Cheesylorry/Quantum-Demonstrator-Lite/pics/IMG_5399.png

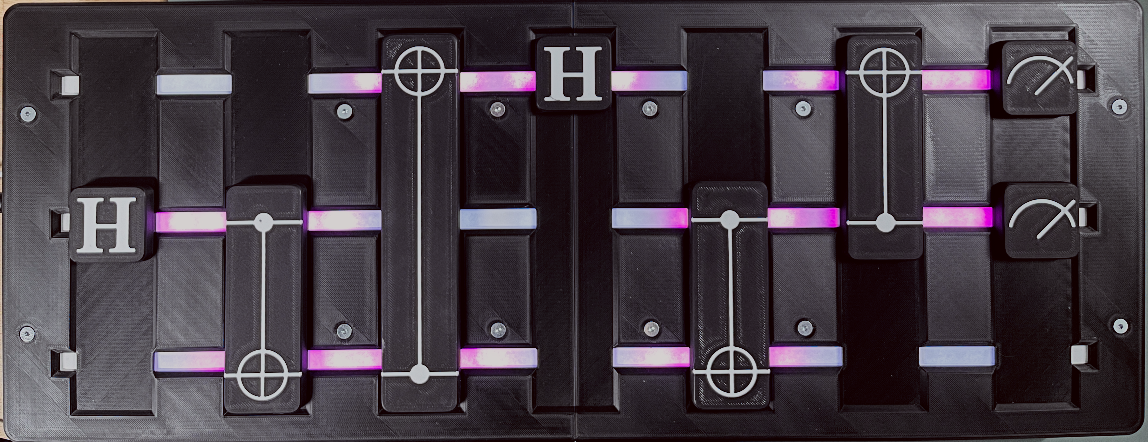
pics/IMG_5399.png
