Cheesylorry/Quantum-Demonstrator-Lite/pics/IMG_5399_v3.png

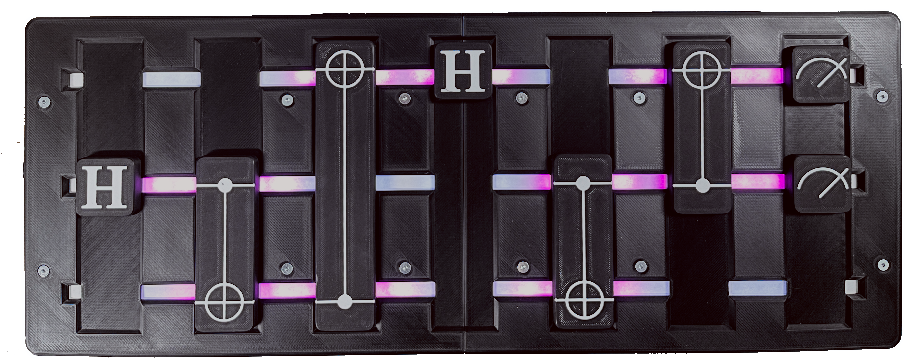
pics/IMG_5399_v3.png
