Cheesylorry/Quantum-Demonstrator-Lite/pics/IMG_5401.JPG

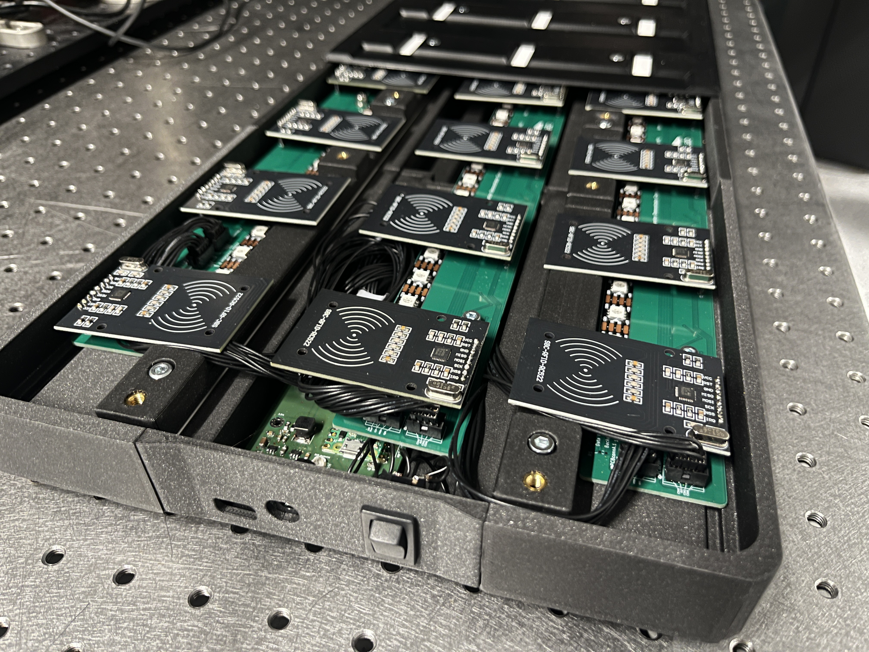
pics/IMG_5401.JPG
