Cheesylorry/Quantum-Demonstrator-Lite/pics/IMG_5409.JPG

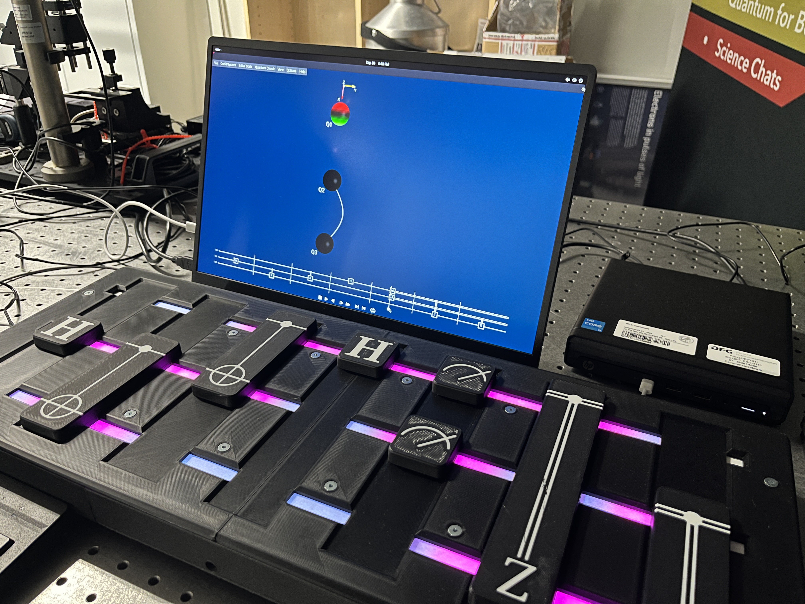
pics/IMG_5409.JPG
