Cheesylorry/Quantum-Demonstrator-Lite/pics/IMG_5411.JPG

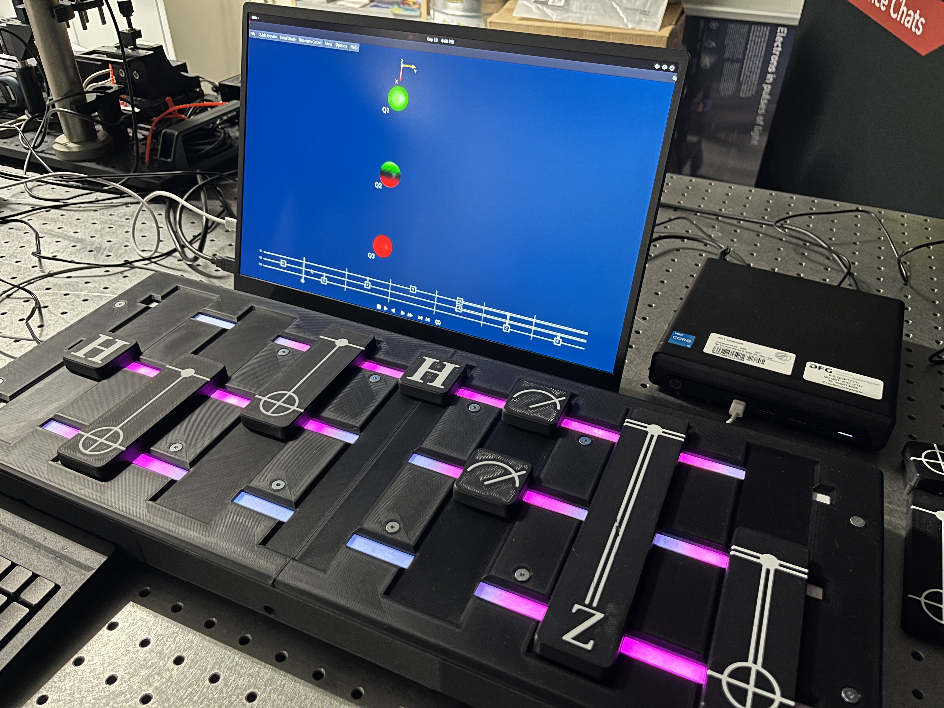
pics/IMG_5411.JPG
