Cheesylorry/Quantum-Demonstrator-Lite/pics/schematic_1.png

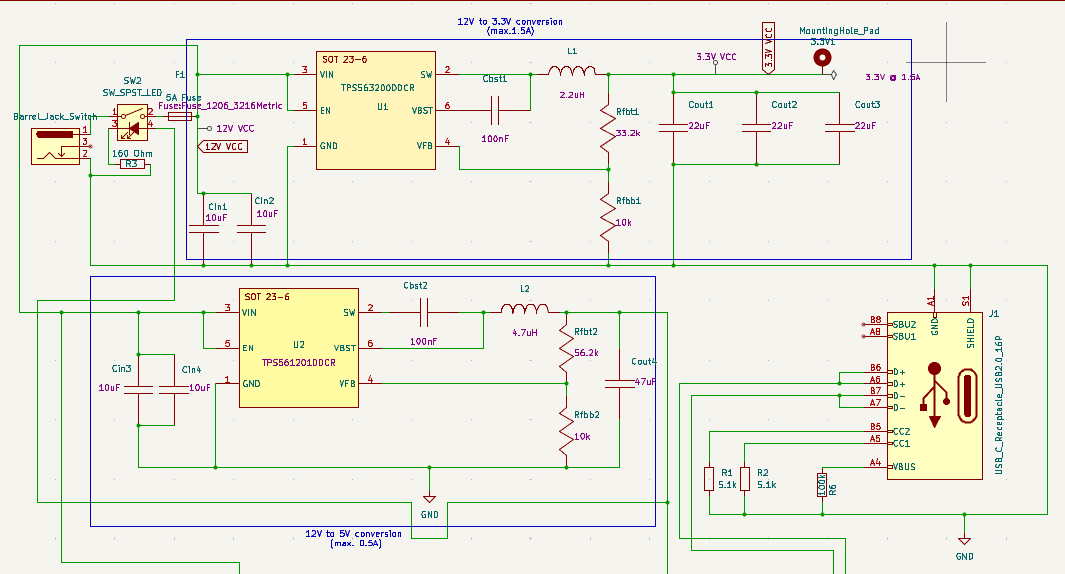
pics/schematic_1.png
