Cheesylorry/Quantum-Demonstrator-Lite/CAD files/Case Parts to 3D Print/All in one.step

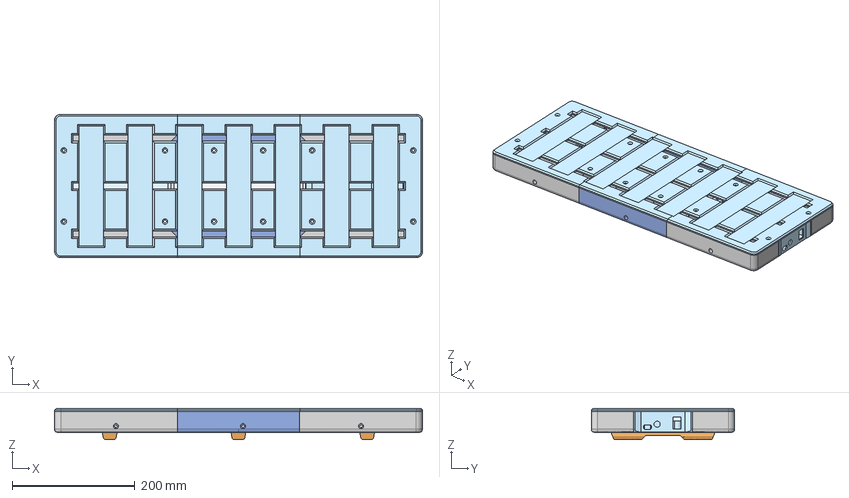
[picture p21: CAD file, 2026-10-16]
CAD files/Case Parts to 3D Print/All in one.step
600.3 x 234.0 x 51.0 mm
Rear Left shoulder x 2
Lid Part 3/1
Front Left shoulder
Foot x 3
Lid Part 1/3
Rear Middle
Middle Left shoulder
Central Front Piece
Rear right Shoulder
Lid Part 2
Middle Right shoulder
Middle Middle
