Cheesylorry/Quantum-Demonstrator-Lite/CAD files/Quantum Gates/Hadamard Gatter.step

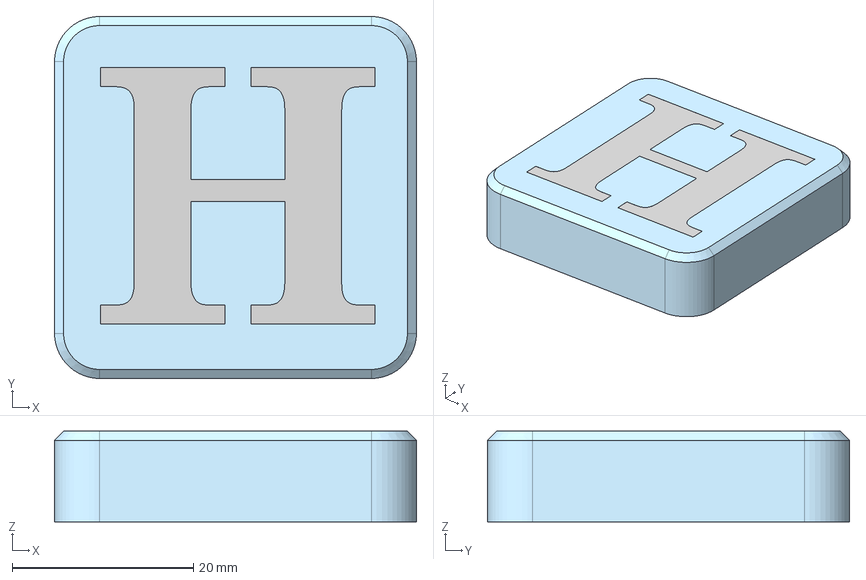
[picture p22: CAD file, 2026-10-16]
CAD files/Quantum Gates/Hadamard Gatter.step
40.0 x 40.0 x 10.0 mm
