Cheesylorry/Quantum-Demonstrator-Lite/CAD files/Quantum Gates/Cnot pos 2.step

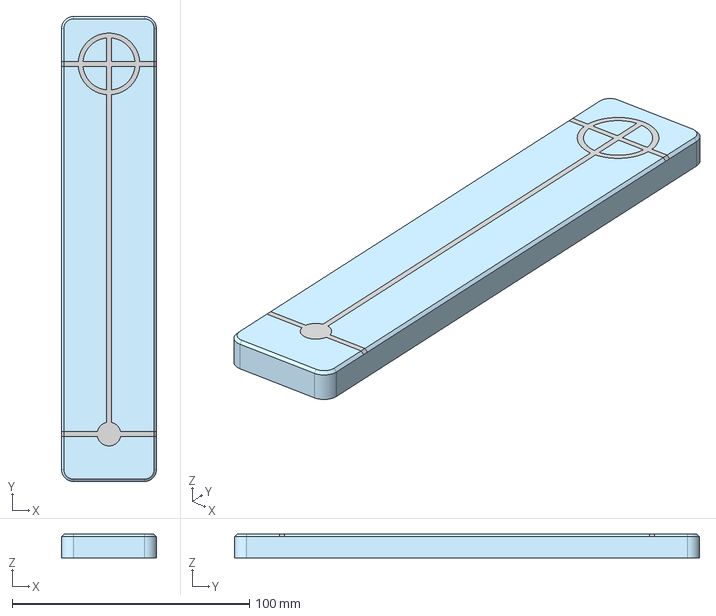
[picture p23: CAD file, 2026-10-16]
CAD files/Quantum Gates/Cnot pos 2.step
40.0 x 196.0 x 10.0 mm
