Cheesylorry/Quantum-Demonstrator-Lite/CAD files/Quantum Gates/CCnot pos 1.step

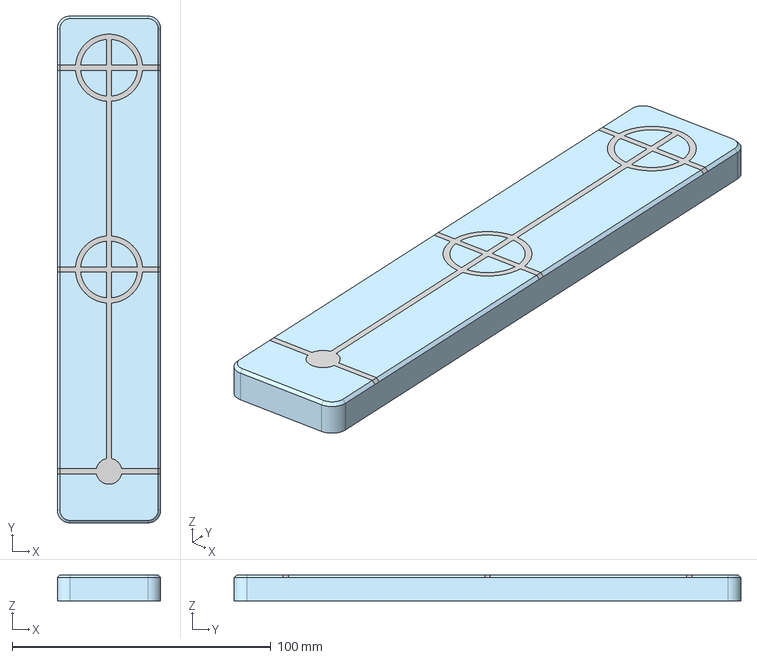
[picture p24: CAD file, 2026-10-16]
CAD files/Quantum Gates/CCnot pos 1.step
40.0 x 196.0 x 10.0 mm
