Cheesylorry/Quantum-Demonstrator-Lite/CAD files/Quantum Gates/Not Gatter.step

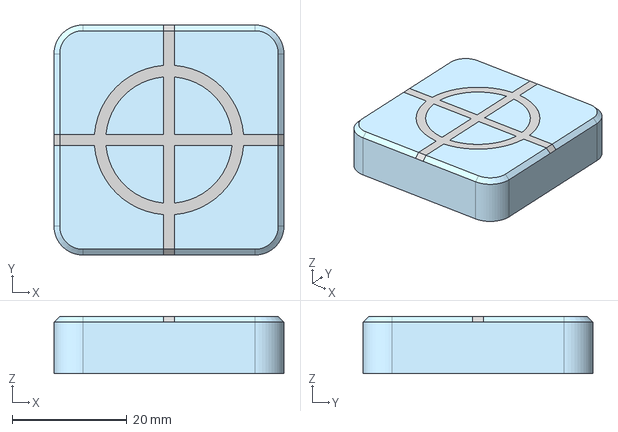
[picture p25: CAD file, 2026-10-16]
CAD files/Quantum Gates/Not Gatter.step
40.0 x 40.0 x 10.0 mm
