Cheesylorry/Quantum-Demonstrator-Lite/CAD files/Quantum Gates/Cnot pos 1.step

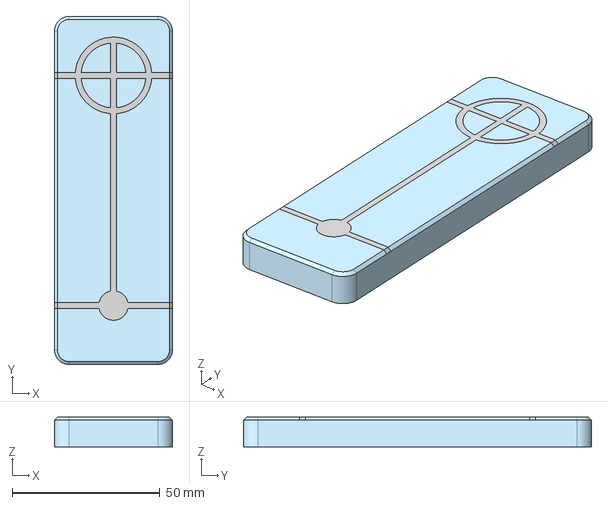
[picture p26: CAD file, 2026-10-16]
CAD files/Quantum Gates/Cnot pos 1.step
40.0 x 118.0 x 10.0 mm
