Cheesylorry/Quantum-Demonstrator-Lite/CAD files/Quantum Gates/Measurement.step

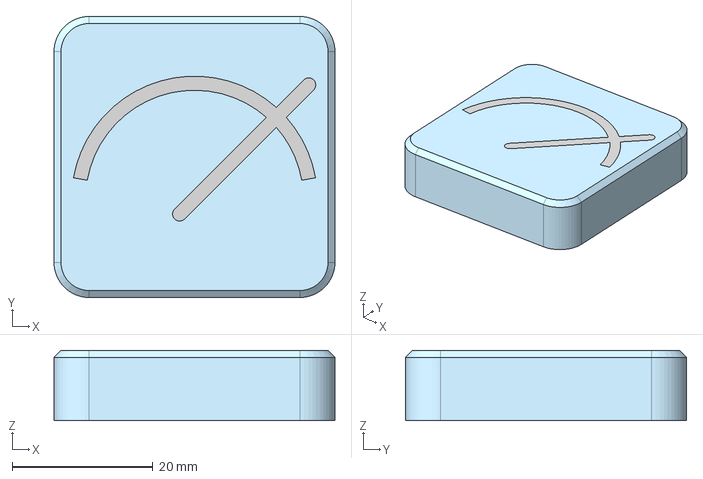
[picture p27: CAD file, 2026-10-16]
CAD files/Quantum Gates/Measurement.step
40.0 x 40.0 x 10.0 mm
