Cheesylorry/Quantum-Demonstrator-Lite/CAD files/Quantum Gates/Cnot classical pos1.step

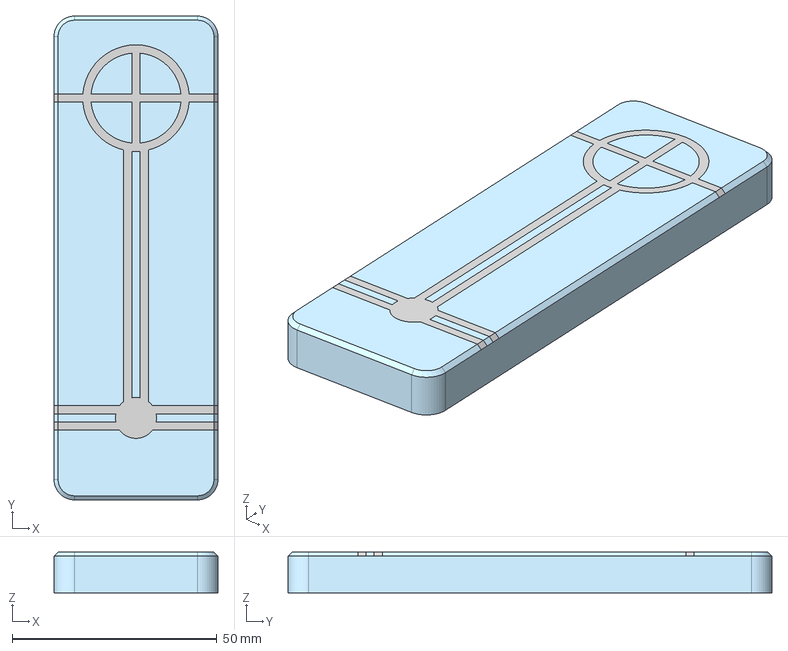
[picture p28: CAD file, 2026-10-16]
CAD files/Quantum Gates/Cnot classical pos1.step
40.0 x 118.0 x 10.0 mm
