Cheesylorry/Quantum-Demonstrator-Lite/CAD files/Complete Model (Including Screws)/QD_Lite_complete_model_V1_16_10_2026.step

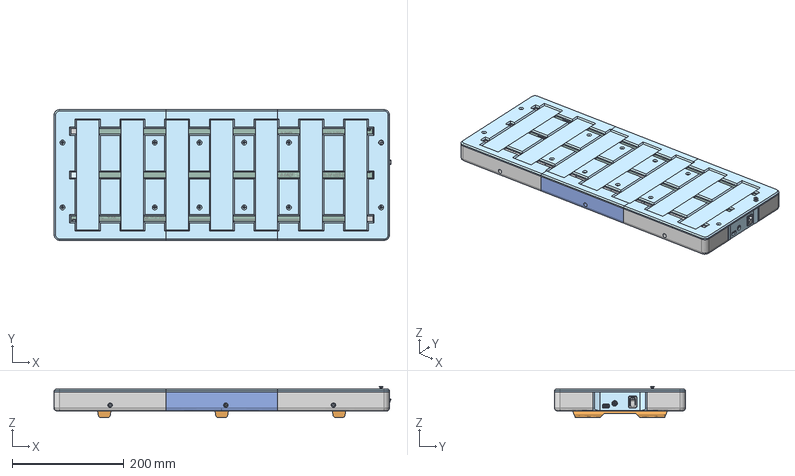
[picture p29: CAD file, 2026-10-16]
CAD files/Complete Model (Including Screws)/QD_Lite_complete_model_V1_16_10_2026.step
602.9 x 234.0 x 55.5 mm
Hex socket head cap screw M4x0.70 x 12 x 31
Hex socket head cap screw M4x0.70 x 40 x 6
Foot x 3
Middle Left shoulder
Rear Middle
Rear Left shoulder x 2
Rear right Shoulder
Lid Part 1/3
Middle Right shoulder
Front Left shoulder
Lid Part 3/1
Central Front Piece
2020_b594mm x 2
Middle Middle
P:\E-Switch Secure\3D_MODELS_STP_FORMAT\R1996AxxxxxxESxxx.stp
Hex socket head countersunk screw grade C M4x0.7 x 10
Lid Part 2
Conn_PCB_silkscreen x 666
R_0603_1608Metric x 6
PinSocket_1x08_P2.54mm_Vertical x 21
Conn_PCB_soldermask x 6
Conn_PCB_PCB x 3
USB_C_Receptacle_GCT_USB4105-xx-A_16P_TopMnt_Horizontal x 36
QD-lite_silkscreen x 292
R_0805_2012Metric x 8
C_0603_1608Metric x 3
SOT-23-6 x 2
QD-lite_soldermask x 2
QD-lite_PCB
C_0805_2012Metric x 6
Fuse_1206_3216Metric
RaspberryPi_Pico_Module_KiCad
L_1008_2520Metric
C_1206_3216Metric
L_APV_ANR6045
6941xx301002_PinBis
6941xx301002_Back
694106301002_PinContact
6941xx301002
6941xx301002_PinLame
6941xx301002_PinContact2
