Cheesylorry/Quantum-Demonstrator-Lite/(list of files, cad)

Other CAD files:
CAD files/Quantum Gates/CCnot pos 2.step
CAD files/Quantum Gates/Measurement classical pos 2.step
CAD files/Quantum Gates/Measurement classical pos 2 v2.step
CAD files/Quantum Gates/Controlled Z pos 2.step
