Cheesylorry/Quantum-Demonstrator-Lite/pics/schematic_main.pdf

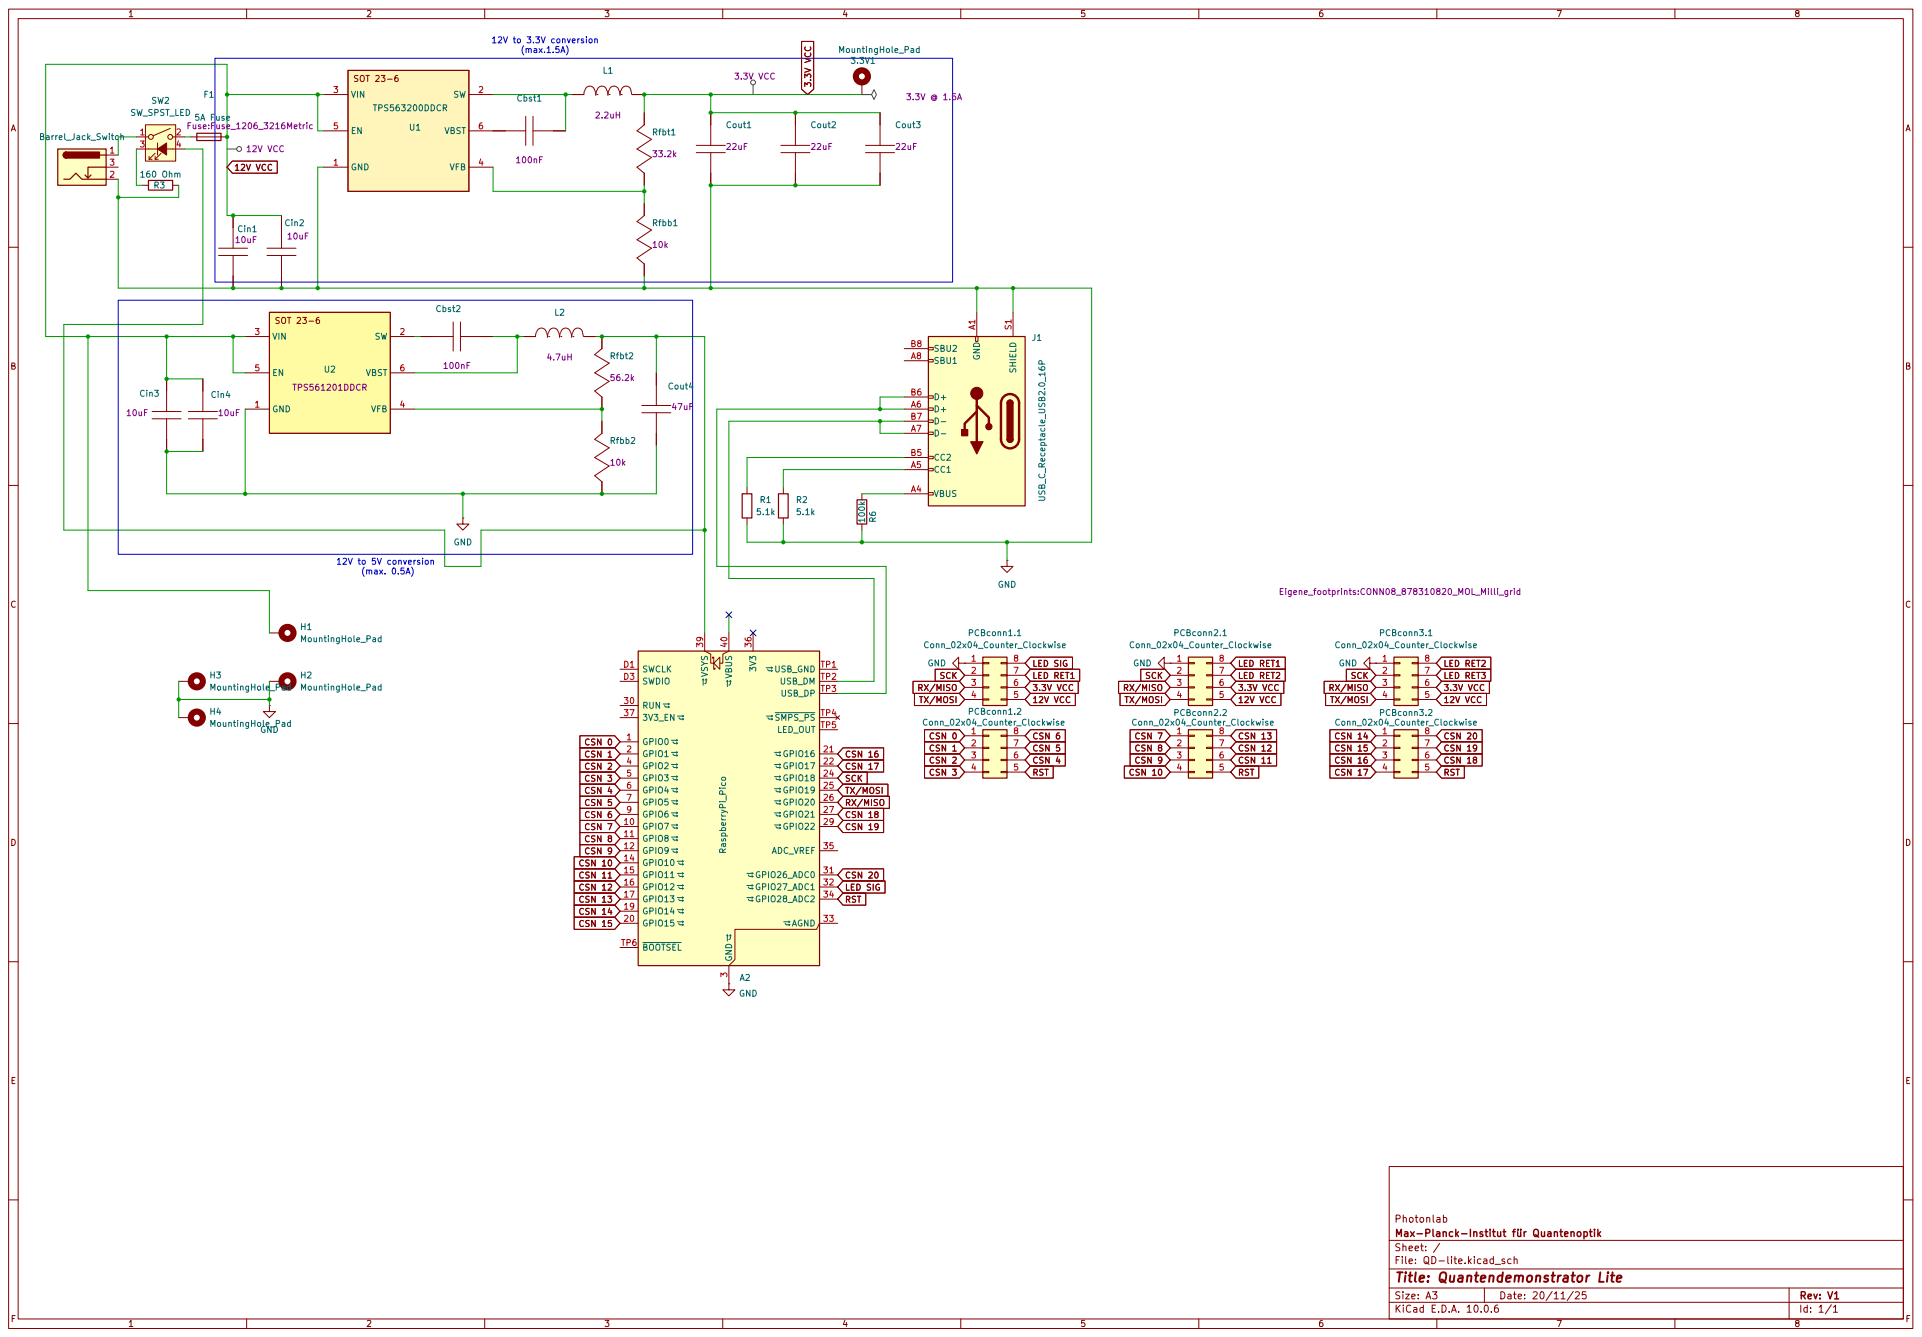
[picture p30: page 1]
