Cheesylorry/Quantum-Demonstrator-Lite/Electronics/Connection_PCB/Conn_PCB.kicad_pcb

## KiCad design Electronics/Connection_PCB/Conn_PCB.kicad_pcb (2026-10-16)

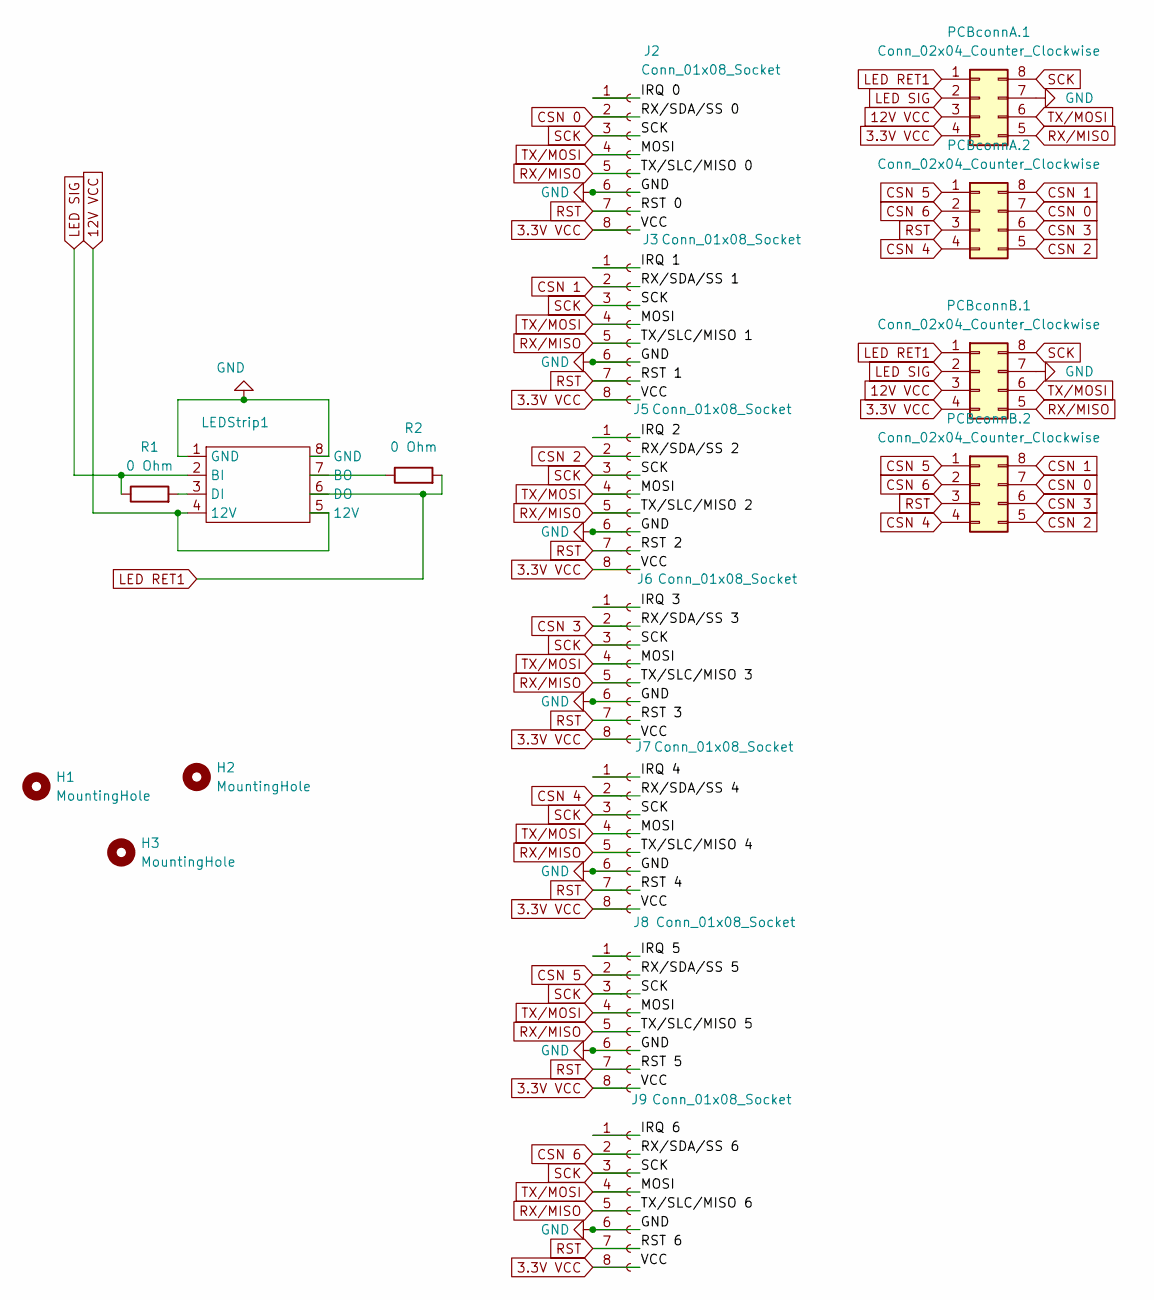
[picture p31: schematic Conn_PCB.kicad_sch]

Parts:
H1, H2: MountingHole; MountingHole_4.3x6.2mm_M4_Pad_Via
H3: MountingHole; MountingHole_4.3mm_M4_ISO14580_Pad
J2, J3, J5, J6, J7, J8, J9: Conn_01x08_Socket; PinSocket_1x08_P2.54mm_Vertical
LEDStrip1: LED strip Pad 2815
PCBconnA.1, PCBconnA.2: Conn_02x04_Counter_Clockwise; CONN08_878310820_MOL_Milli_grid
PCBconnB.1, PCBconnB.2: Conn_02x04_Counter_Clockwise; CONN08_878310820_MOL_Milli_grid
R1, R2: 0 Ohm; R_0603_1608Metric_Pad0.98x0.95mm_HandSolder

Connections:
3.3V VCC: J2.8, J3.8, J5.8, J6.8, J7.8, J8.8, J9.8, PCBconnA.1.4, PCBconnB.1.4
12V VCC: LEDStrip1.4 (12V), LEDStrip1.5 (12V), PCBconnA.1.3, PCBconnB.1.3
/IRQ 0: J2.1
/IRQ 1: J3.1
/IRQ 2: J5.1
/IRQ 3: J6.1
/IRQ 4: J7.1
/IRQ 5: J8.1
/IRQ 6: J9.1
CSN 0: J2.2, PCBconnA.2.7, PCBconnB.2.7
CSN 1: J3.2, PCBconnA.2.8, PCBconnB.2.8
CSN 2: J5.2, PCBconnA.2.5, PCBconnB.2.5
CSN 3: J6.2, PCBconnA.2.6, PCBconnB.2.6
CSN 4: J7.2, PCBconnA.2.4, PCBconnB.2.4
CSN 5: J8.2, PCBconnA.2.1, PCBconnB.2.1
CSN 6: J9.2, PCBconnA.2.2, PCBconnB.2.2
GND: J2.6, J3.6, J5.6, J6.6, J7.6, J8.6, J9.6, LEDStrip1.1 (GND), LEDStrip1.8 (GND), PCBconnA.1.7, PCBconnB.1.7
LED RET1: LEDStrip1.6 (DO), PCBconnA.1.1, PCBconnB.1.1, R2.2
LED SIG: LEDStrip1.2 (BI), PCBconnA.1.2, PCBconnB.1.2, R1.1
unnamed: LEDStrip1.7 (BO), R2.1
unnamed: LEDStrip1.3 (DI), R1.2
RST: J2.7, J3.7, J5.7, J6.7, J7.7, J8.7, J9.7, PCBconnA.2.3, PCBconnB.2.3
RX/MISO: J2.5, J3.5, J5.5, J6.5, J7.5, J8.5, J9.5, PCBconnA.1.5, PCBconnB.1.5
SCK: J2.3, J3.3, J5.3, J6.3, J7.3, J8.3, J9.3, PCBconnA.1.8, PCBconnB.1.8
TX/MOSI: J2.4, J3.4, J5.4, J6.4, J7.4, J8.4, J9.4, PCBconnA.1.6, PCBconnB.1.6

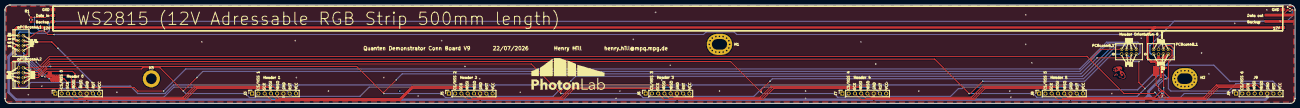
[picture p32: board Conn_PCB.kicad_pcb from above]

Board: 2 copper layers, 524.5 x 40.0 mm, 17 parts (0 on the bottom side), 18 nets.
