Cheesylorry/Quantum-Demonstrator-Lite/Electronics/Main_PCB/QD-lite.kicad_pcb

## KiCad design Electronics/Main_PCB/QD-lite.kicad_pcb (2026-10-16)

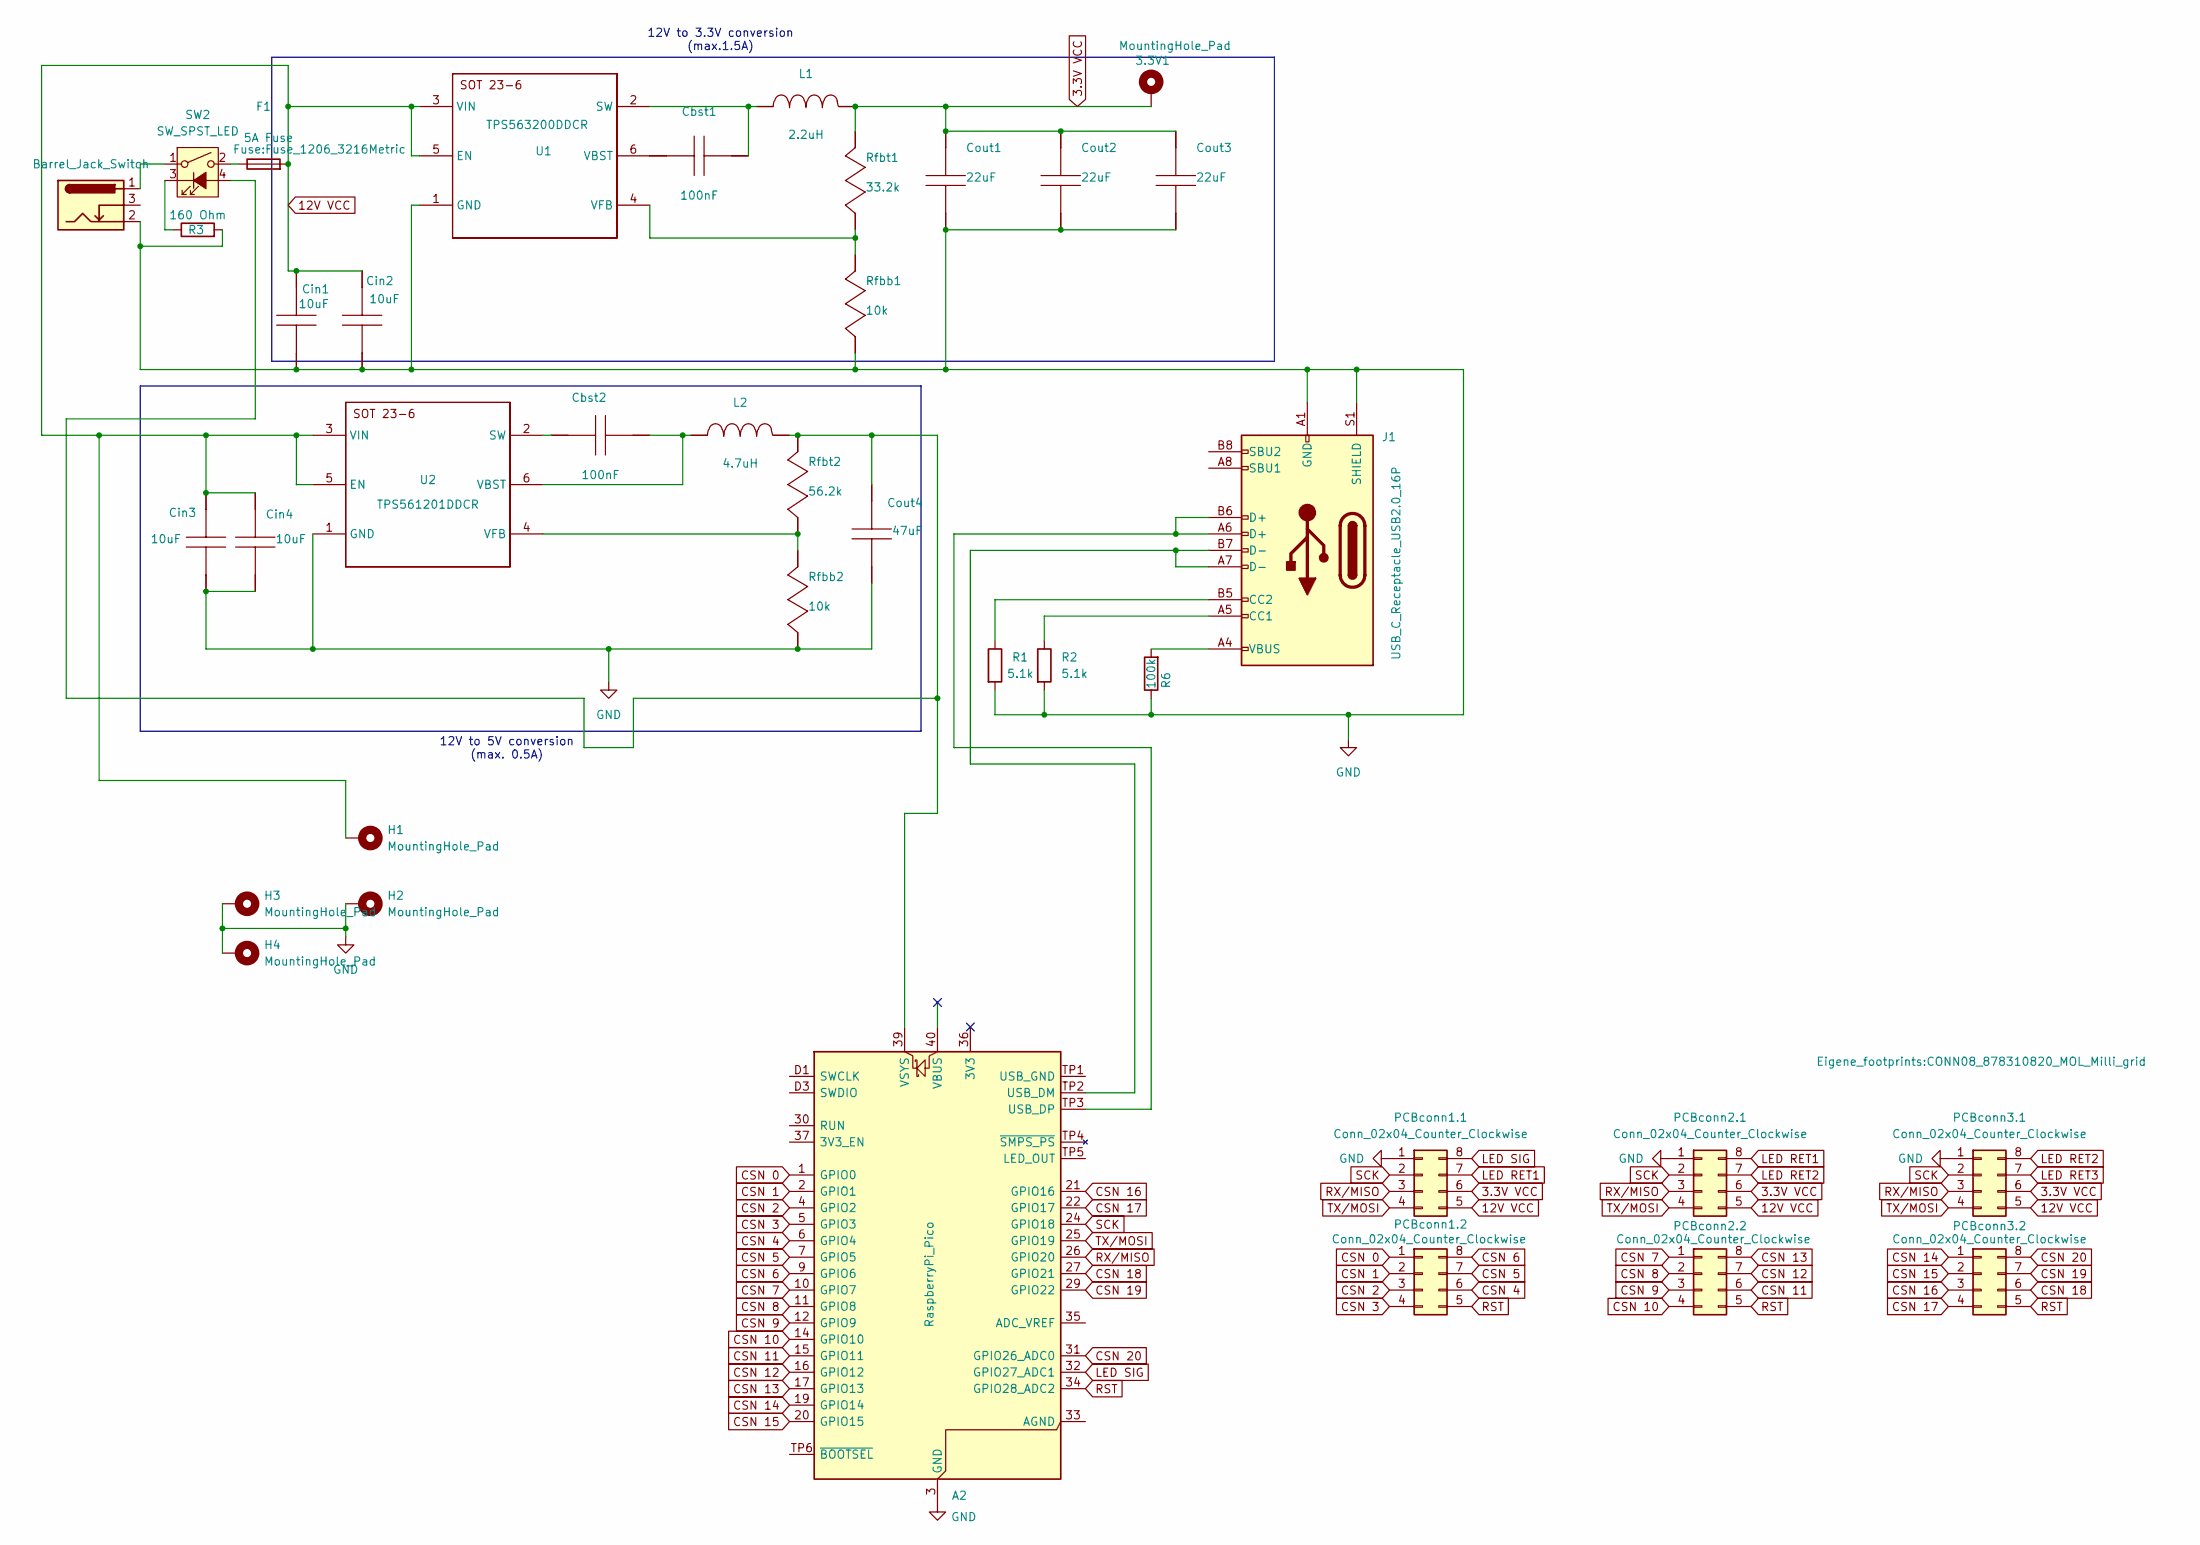
[picture p33: schematic QD-lite.kicad_sch, Quantendemonstrator Lite]

Parts:
3.3V1: MountingHole_Pad; MountingHole_2.5mm_Pad_Via
A2: RaspberryPi_Pico; RaspberryPi_Pico_SMD
Cbst1, Cbst2: 08053C104KAT2A; C_0805_2012Metric_Pad1.18x1.45mm_HandSolder; MANUFACTURER PART NUMBER 08053C104KAT2A
Cin1, Cin2: MSAST219LB5106KTNA01; C_0805_2012Metric_Pad1.18x1.45mm_HandSolder; MANUFACTURER PART NUMBER MSAST219LB5106KTNA01
Cin3, Cin4: MSAST219LB5106KTNA01; C_0805_2012Metric_Pad1.18x1.45mm_HandSolder; MANUFACTURER PART NUMBER MSAST21GBB5106MTNA01
Cout1, Cout2, Cout3: GRM188R60J226MEA0D; C_0603_1608Metric_Pad1.08x0.95mm_HandSolder; MANUFACTURER PART NUMBER GRM188R60J226MEA0D
Cout4: C3216X5R1C476M160AB; C_1206_3216Metric_Pad1.33x1.80mm_HandSolder; MANUFACTURER PART NUMBER C3216X5R1C476M160AB
F1: 5A Fuse; Fuse_1206_3216Metric
H1, H2: MountingHole_Pad; MountingHole_2.2mm_M2_DIN965_Pad_TopBottom
H3, H4: MountingHole_Pad; MountingHole_2.7mm_M2.5_Pad_Via
J1: USB_C_Receptacle_USB2.0_16P; USB_C_Receptacle_GCT_USB4105-xx-A_16P_TopMnt_Horizontal
J4: Barrel_Jack_Switch; BarrelJack_Wuerth_6941xx301002_CAD
L1: VLS6045EX-2R2N; L_APV_ANR6045; MANUFACTURER PART NUMBER VLP8040T-2R2N
L2: LQM2HPN4R7MG0L; L_1008_2520Metric_Pad1.43x2.20mm_HandSolder; MANUFACTURER PART NUMBER LQM2HPN4R7MG0L
PCBconn1.1, PCBconn1.2, PCBconn2.1, PCBconn2.2, PCBconn3.1, PCBconn3.2: Conn_02x04_Counter_Clockwise; CONN08_878310820_MOL_Milli_grid
R1: 5.1k; R_0805_2012Metric_Pad1.20x1.40mm_HandSolder
R2: 5.1k; R_0805_2012Metric
R3: 160 Ohm; R_0805_2012Metric_Pad1.20x1.40mm_HandSolder
R6: 100k; R_0805_2012Metric
Rfbb1, Rfbb2: RC0805FR-0710KL; R_0805_2012Metric_Pad1.20x1.40mm_HandSolder; MANUFACTURER PART NUMBER RC0805FR-0710KL
Rfbt1: CRCW080533K2FKEA; R_0805_2012Metric_Pad1.20x1.40mm_HandSolder; MANUFACTURER PART NUMBER CRCW080533K2FKEA
Rfbt2: RC0805FR-0756K2L; R_0805_2012Metric_Pad1.20x1.40mm_HandSolder; MANUFACTURER PART NUMBER RC0805FR-0756K2L
SW2: SW_SPST_LED; R1966ABLKBLKESRED footprint
U1: TPS563200DDCR; SOT-23-6; MANUFACTURER PART NUMBER TPS563209DDCR
U2: TPS561201DDCR; SOT-23-6; MANUFACTURER PART NUMBER TPS561201DDCR

Connections:
3.3V VCC: 3.3V1.1 (1_1), Cout1.1, Cout2.1, Cout3.1, L1.2, PCBconn1.1.6, PCBconn2.1.6, PCBconn3.1.6, Rfbt1.1
12V VCC: Cin1.1, Cin2.1, Cin3.1, Cin4.1, F1.2, H1.1 (1_1), PCBconn1.1.5, PCBconn2.1.5, PCBconn3.1.5, U1.3 (VIN), U1.5 (EN), U2.3 (VIN), U2.5 (EN)
CSN 0: A2.1 (GPIO0), PCBconn1.2.1
CSN 1: A2.2 (GPIO1), PCBconn1.2.2
CSN 2: A2.4 (GPIO2), PCBconn1.2.3
CSN 3: A2.5 (GPIO3), PCBconn1.2.4
CSN 4: A2.6 (GPIO4), PCBconn1.2.6
CSN 5: A2.7 (GPIO5), PCBconn1.2.7
CSN 6: A2.9 (GPIO6), PCBconn1.2.8
CSN 7: A2.10 (GPIO7), PCBconn2.2.1
CSN 8: A2.11 (GPIO8), PCBconn2.2.2
CSN 9: A2.12 (GPIO9), PCBconn2.2.3
CSN 10: A2.14 (GPIO10), PCBconn2.2.4
CSN 11: A2.15 (GPIO11), PCBconn2.2.6
CSN 12: A2.16 (GPIO12), PCBconn2.2.7
CSN 13: A2.17 (GPIO13), PCBconn2.2.8
CSN 14: A2.19 (GPIO14), PCBconn3.2.1
CSN 15: A2.20 (GPIO15), PCBconn3.2.2
CSN 16: A2.21 (GPIO16), PCBconn3.2.3
CSN 17: A2.22 (GPIO17), PCBconn3.2.4
CSN 18: A2.27 (GPIO21), PCBconn3.2.6
CSN 19: A2.29 (GPIO22), PCBconn3.2.7
CSN 20: A2.31 (GPIO26_ADC0), PCBconn3.2.8
GND: A2.3 (GND), A2.8 (GND), A2.13 (GND), A2.18 (GND), A2.23 (GND), A2.28 (GND), A2.38 (GND), A2.D2 (GND), Cin1.2, Cin2.2, Cin3.2, Cin4.2, Cout1.2, Cout2.2, Cout3.2, Cout4.2, H2.1 (1_1), H3.1 (1_1), H4.1 (1_1), J1.A1 (GND), J1.A12 (GND), J1.B1 (GND), J1.B12 (GND), J1.S1 (SHIELD), J4.2, PCBconn1.1.1, PCBconn2.1.1, PCBconn3.1.1, R1.2, R2.2, R3.2, R6.1, Rfbb1.2, Rfbb2.2, U1.1 (GND), U2.1 (GND)
LED RET1: PCBconn1.1.7, PCBconn2.1.8
LED RET2: PCBconn2.1.7, PCBconn3.1.8
LED RET3: PCBconn3.1.7
LED SIG: A2.32 (GPIO27_ADC1), PCBconn1.1.8
unnamed: A2.TP2 (USB_DM), J1.A7 (D-), J1.B7 (D-)
unnamed: A2.TP3 (USB_DP), J1.A6 (D+), J1.B6 (D+)
unnamed: A2.39 (VSYS), Cout4.1, L2.2, Rfbt2.1, SW2.4 (A)
unnamed: F1.1, SW2.2
unnamed: J1.A5 (CC1), R2.1
unnamed: J1.B5 (CC2), R1.1
unnamed: J1.A4 (VBUS), J1.A9 (VBUS), J1.B4 (VBUS), J1.B9 (VBUS), R6.2
unnamed: J4.1, SW2.1
unnamed: R3.1, SW2.3 (K)
unnamed: Cbst1.1, L1.1, U1.2 (SW)
unnamed: Cbst1.2, U1.6 (VBST)
unnamed: Rfbb1.1, Rfbt1.2, U1.4 (VFB)
unnamed: Cbst2.2, U2.2 (SW)
unnamed: Cbst2.1, L2.1, U2.6 (VBST)
unnamed: Rfbb2.1, Rfbt2.2, U2.4 (VFB)
RST: A2.34 (GPIO28_ADC2), PCBconn1.2.5, PCBconn2.2.5, PCBconn3.2.5
RX/MISO: A2.26 (GPIO20), PCBconn1.1.3, PCBconn2.1.3, PCBconn3.1.3
SCK: A2.24 (GPIO18), PCBconn1.1.2, PCBconn2.1.2, PCBconn3.1.2
TX/MOSI: A2.25 (GPIO19), PCBconn1.1.4, PCBconn2.1.4, PCBconn3.1.4

Notes on the sheet:
12V to 3.3V conversion (max.1.5A)
12V to 5V conversion (max. 0.5A)

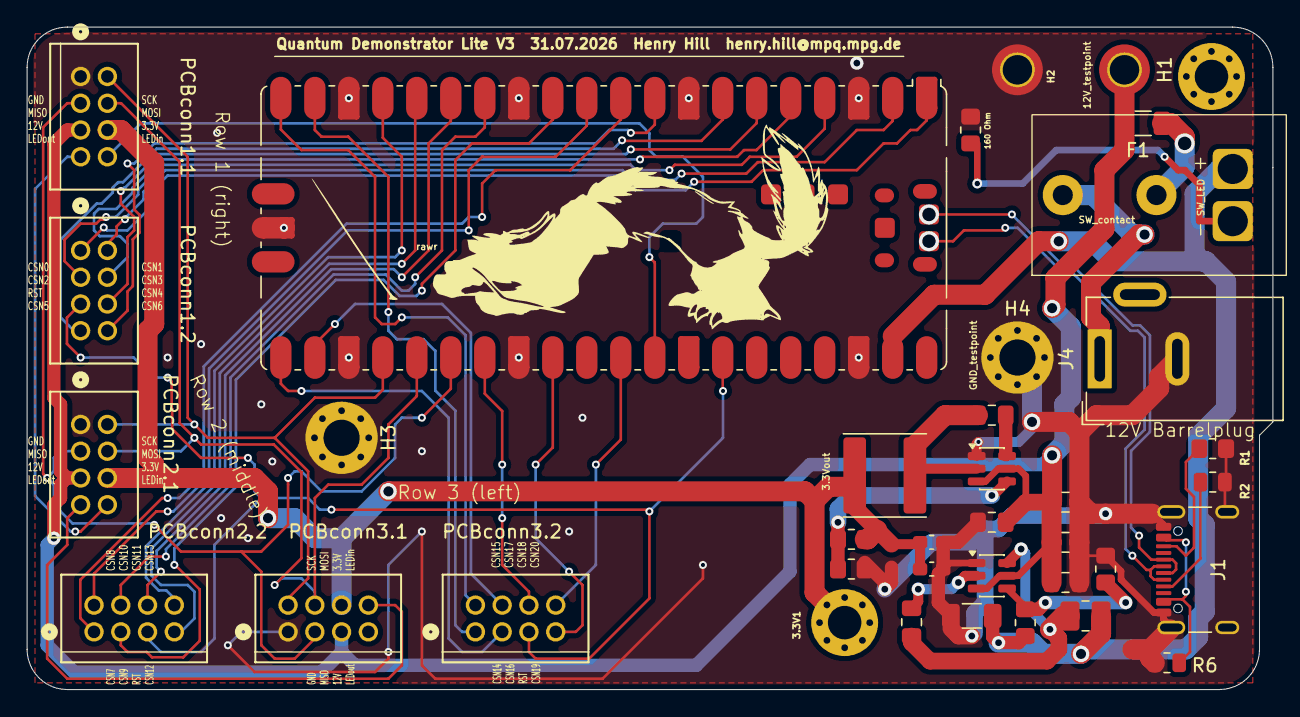
[picture p34: board QD-lite.kicad_pcb from above]

Board: 2 copper layers, 93.1 x 49.5 mm, 39 parts (1 on the bottom side), 46 nets.

Other parts of the board:
M2.5: MountingHole_2.5mm_Pad_Via
