Cheesylorry/Quantum-Demonstrator-Lite/(commit log)

2026-10-16 Update 1
    [Conn_PCB.kicad_pcb, Conn_PCB.kicad_sch, QD-lite.kicad_pcb, QD-lite.kicad_sch, gates.csv]
2026-10-16 Expanded README.md, added PC side implimentation.
    [QD_Lite_complete_model_V1_16_10_2026.step, gates.csv]
2026-10-16 Push to prod on a Friday
    [All in one.step, Cnot classical pos1.step, Hadamard Gatter.step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]
2026-10-21 Fixed Typos, Fixed witing errors, redid naming, added comments
    [composer.py, enroll.py, writer.py]
2026-10-22 Updated Readme, Improved Comments in code, fixed writing error
    [database.py, enroll.py, selftest.py, serial_link.py]
