Cheesylorry/Quantum-Demonstrator-Lite/pics/IMG_5399.JPG

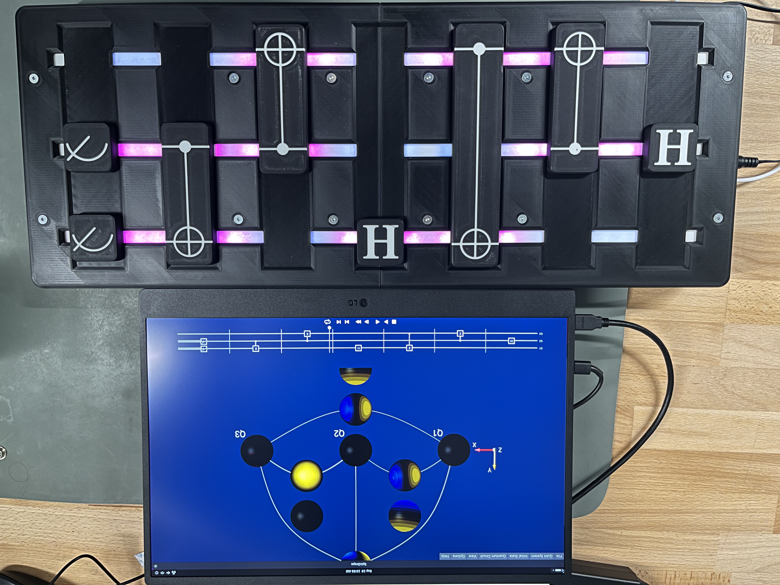
pics/IMG_5399.JPG
