Cheesylorry/Quantum-Demonstrator-Lite/pics/IMG_5399_v2.png

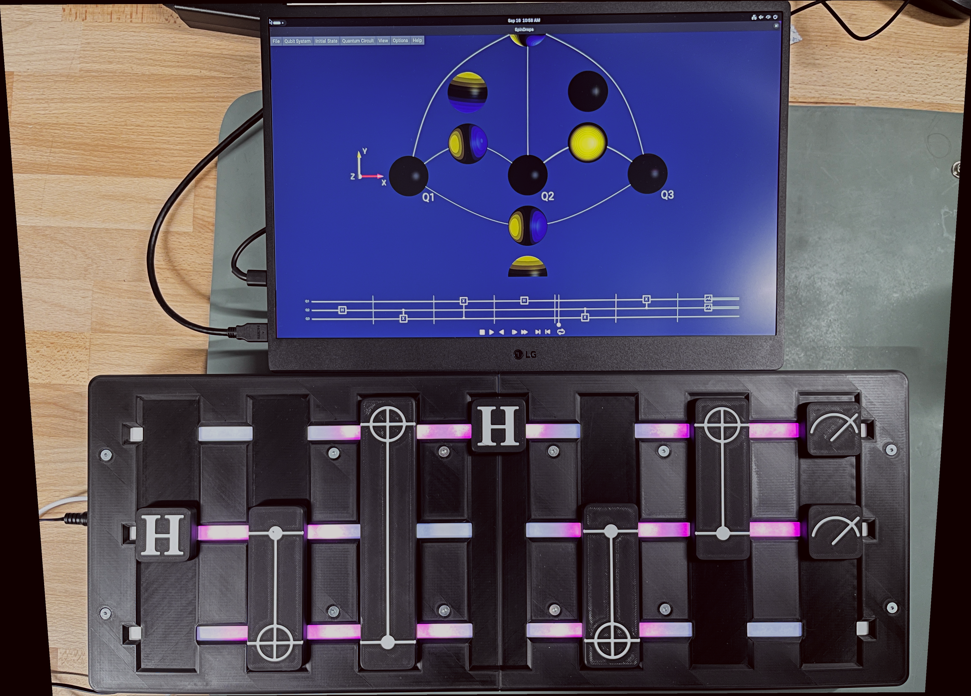
pics/IMG_5399_v2.png
