Cheesylorry/Quantum-Demonstrator-Lite/pics/IMG_5400.JPG

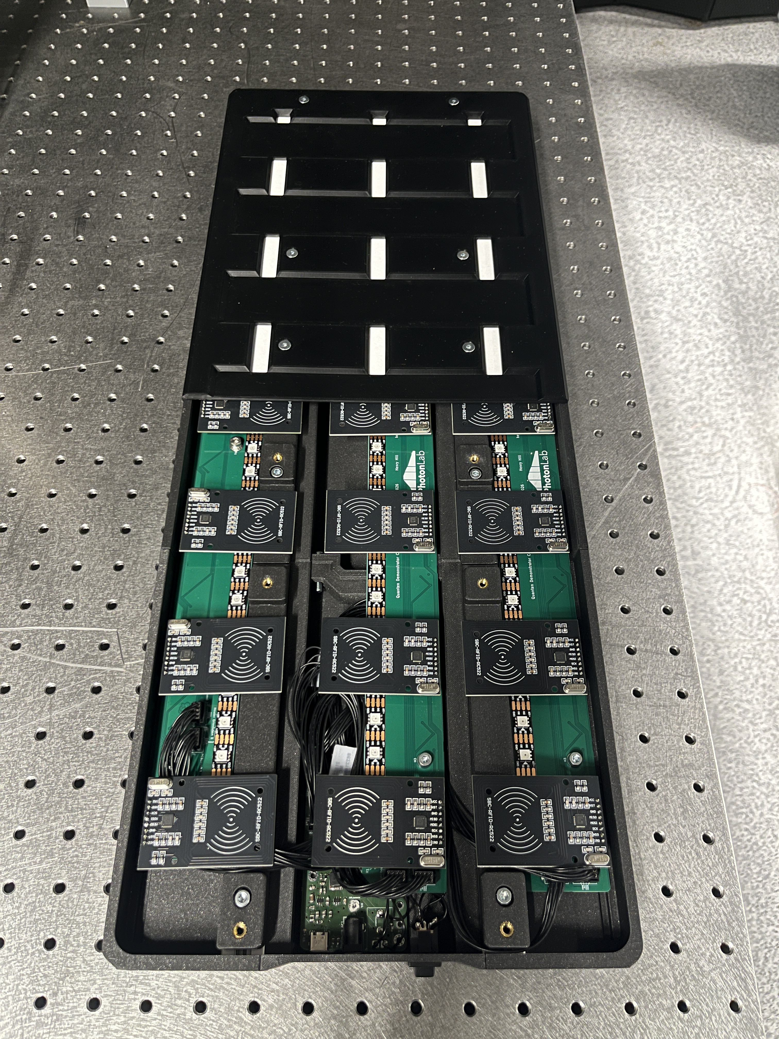
pics/IMG_5400.JPG
