Cheesylorry/Quantum-Demonstrator-Lite/pics/IMG_5402.JPG

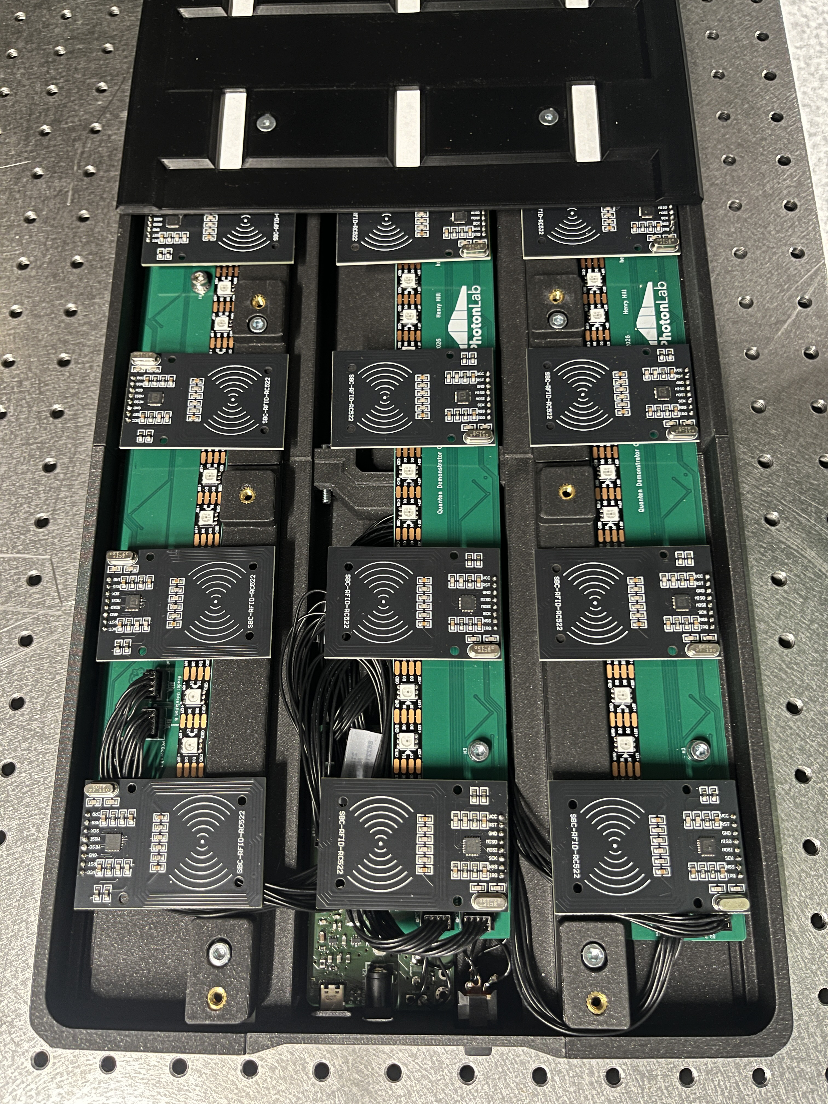
pics/IMG_5402.JPG
