Cheesylorry/Quantum-Demonstrator-Lite/pics/IMG_5403.JPG

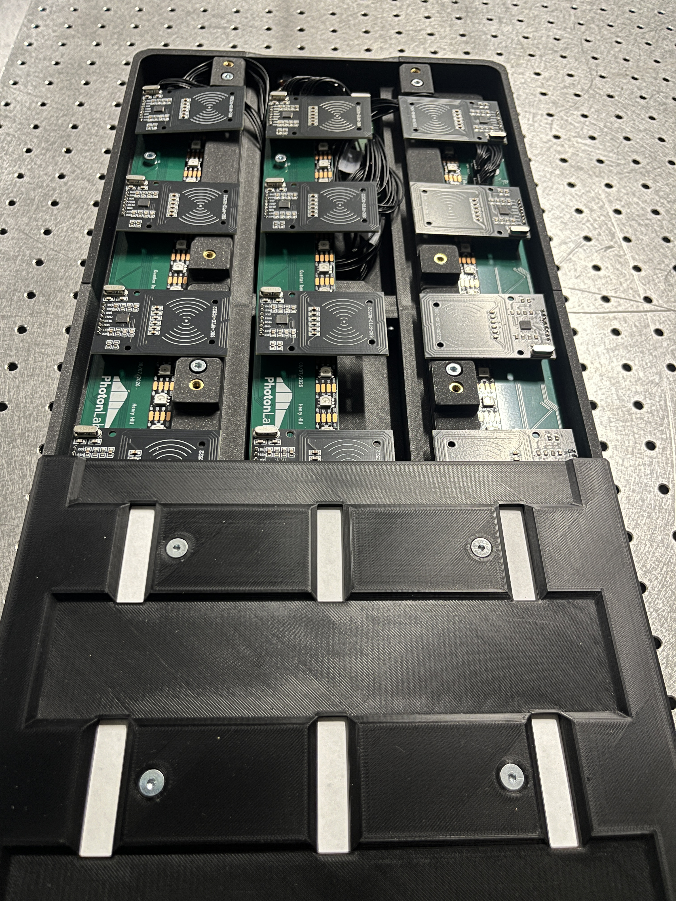
pics/IMG_5403.JPG
